thutapea/milotx/0.3mmviaTransmitter/floorplan.png

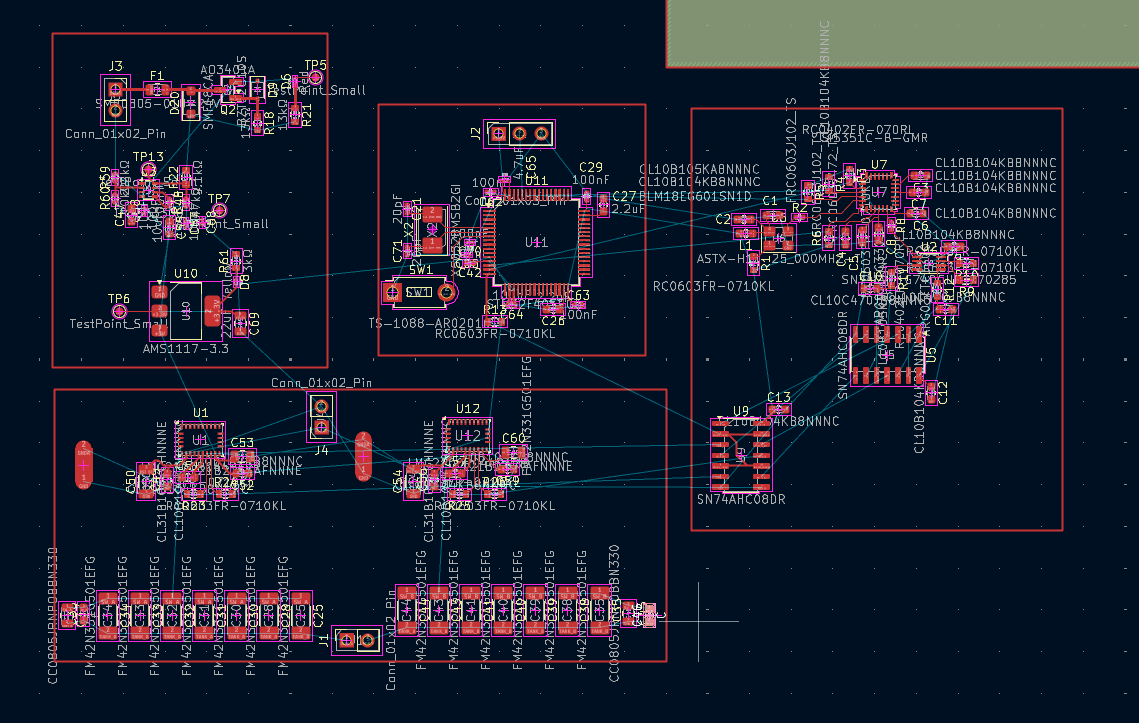
0.3mmviaTransmitter/floorplan.png
