thutapea/milotx/0.3mmviaTransmitter/sim1.png

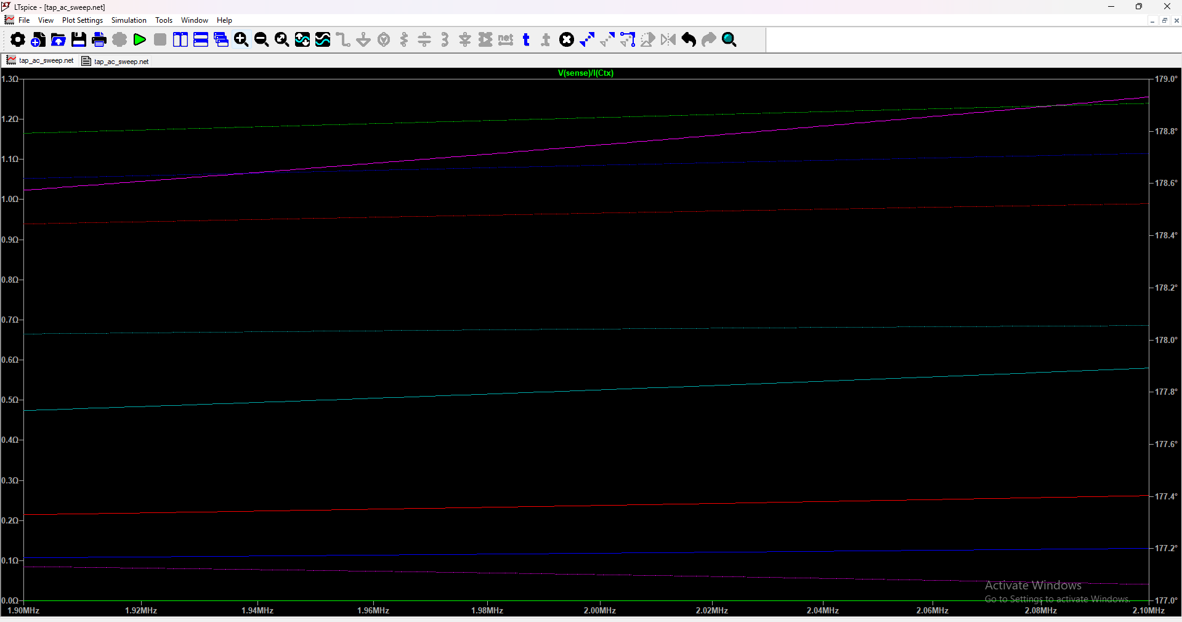
0.3mmviaTransmitter/sim1.png
