thutapea/milotx/0.3mmviaTransmitter/TX/production/bom.csv

Designator | Footprint | Quantity | Value | LCSC Part #
C1, C12, C13, C3, C4, C5, C51, C52, C57, C59, C6, C7, C9 | 0603 | 13 | CL10B104KB8NNNC | C1591
C10, C11 | 0603 | 2 | CL10C470JB8NNNC | C1671
C14, C15 | 0805 | 2 | CL21B105KBFNNNE | C28323
C16 | 1206 | 1 | CL31B475KBHNNNE | C51205
C17 | 0805 | 1 | CL21A226MAQNNNE | C45783
C2, C8 | 0603 | 2 | CL10B105KA8NNNC | C29936
C21, C71 | 0402 | 2 | 20pF | C1554
C25, C28, C30, C31, C32, C33, C34, C35, C38, C39, C40, C41, C43, C44 | 1808 | 14 | FM42N331G501EFG | C22376361
C26, C27 | 0603 | 2 | 2.2uF | C23630
C29, C42, C48, C62, C63, C64 | 0402 | 6 | 100nF | C1525
C37, C45 | 0805 | 2 | CC0805JRNPOBBN330 | C113838
C47, C55 | 0603 | 2 | 10uF | C96446
C49, C56 | 0603 | 2 | CL10B104KC8NNNC | C15725
C50, C54 | 1206 | 2 | CL31B105KCHNNNE | C13832
C53, C60 | 0805 | 2 | CL21B225KAFNNNE | C19110
C58, C68, C70 | 0603 | 3 | 100nF | C14663
C65 | 0603 | 1 | 4.7uF | C19666
C66 | 0603 | 1 | 1uF | C15849
C69 | 0805 | 1 | 22uF | C45783
D20 | D_SOD-123F | 1 | SMF18CA | C19077513
D6 | 0603 | 1 | Red | C2286
D8 | 0603 | 1 | Yellow | C89811
D9 | D_SOD-323 | 1 | BZT52C10S | C19077446
F2 | SMD1812P050TF_30_C492015 | 1 | SMD1812P050TF_30_C492015 | C492015
L1 | 0603 | 1 | BLM18EG601SN1D | C20345
Q2 | SOT-23 | 1 | AO3401A
R1, R10, R13, R23, R24, R25, R26, R6, R9 | 0603 | 9 | RC0603FR-0710KL | C98220
R11, R12 | 0603 | 2 | ARG03FTC3300 | C217969
R18, R21 | 0603 | 2 | 13kΩ | C22797
R2, R8 | 0402 | 2 | RC0402FR-070RL | C106231
R22 | 0603 | 1 | 9.1kΩ | C23260
R3 | 0603 | 1 | FRC0603J472_TS | C2907166
R34 | 0402 | 1 | 47kΩ | C25792
R4, R5 | 0603 | 2 | FRC0603J102_TS | C2907113
R59 | 0402 | 1 | 2.2kΩ | C25879
R60 | 0402 | 1 | 10kΩ | C25744
R61 | 0603 | 1 | 3kΩ | C4211
RF1 | SMA-KWE901 | 1 | SMA-KWE901 | C914553
SW1 | SW_PUSH_1P1T_6x3.5mm_H5.0_APEM_MJTP1250 | 1 | TS-1088-AR02016 | C54141293
U1, U12 | LMG2100R044RARR | 2 | LMG2100R044RARR | C22453052
U10 | SOT-223-3_TabPin2 | 1 | AMS1117-3.3
U11 | LQFP-64_10x10mm_P0.5mm | 1 | STM32F405RGTx | C15742
U13 | SRR1208-120ML | 1 | SRR1208-120ML | C1329356
U2 | VSSOP-8_2.3x2mm_P0.5mm | 1 | SN74LVC1G74DCUR_C70285 | C70285
U3 | SOT-583-8 | 1 | TPS563300
U4, U8 | Molex_Micro-Fit_3.0_43045-0412_2x02_P3.00mm_Vertical | 2 | 430450412 | C277721
U5, U9 | SOIC-14_3.9x8.7mm_P1.27mm | 2 | SN74AHC08DR | C6937
U6 | Crystal_SMD_3225-4Pin_3.2x2.5mm | 1 | ASTX-H11-25_000MHZ-T | C7217716
U7 | SI5351C-B-GMR | 1 | SI5351C-B-GMR | C2649375
X2 | Crystal_SMD_5032-2Pin_5.0x3.2mm | 1 | X50328MSB2GI | C115962
