thutapea/milotx/0.3mmviaTransmitter/TX/TX.kicad_pcb

## KiCad design 0.3mmviaTransmitter/TX/TX.kicad_pcb (2026-10-14)

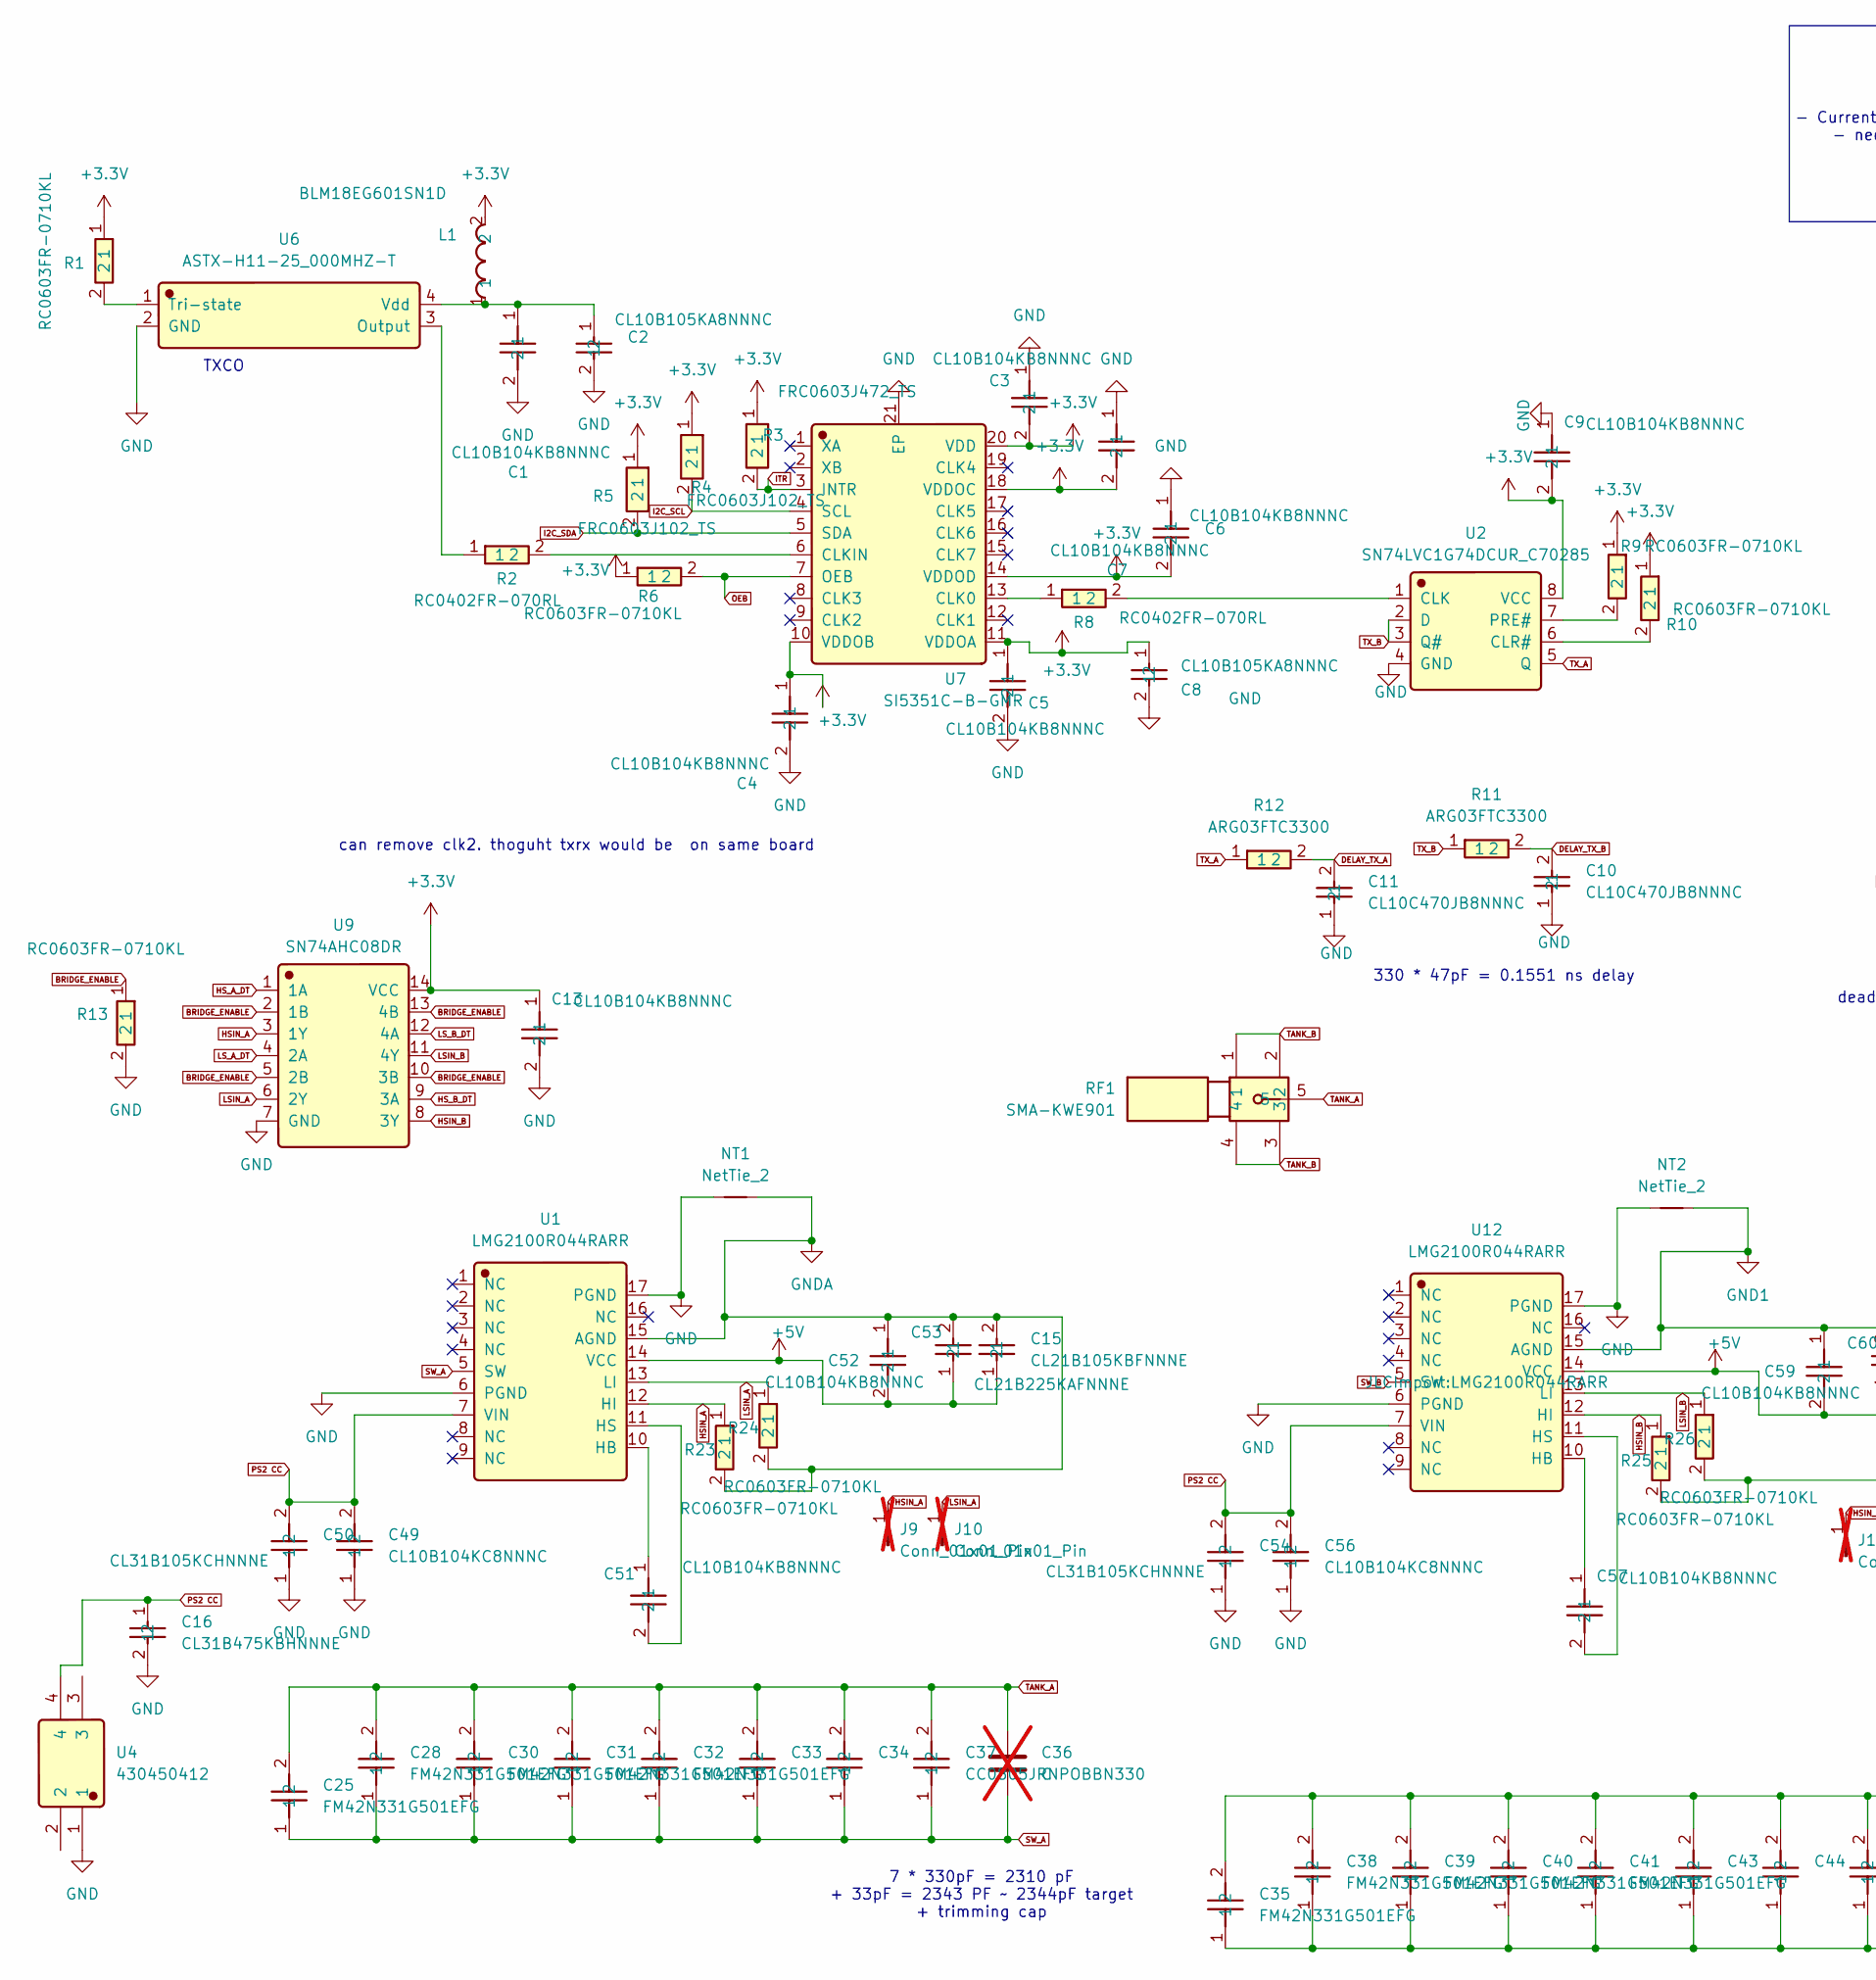
[picture p3: schematic TX.kicad_sch, part in row 1, column 1]

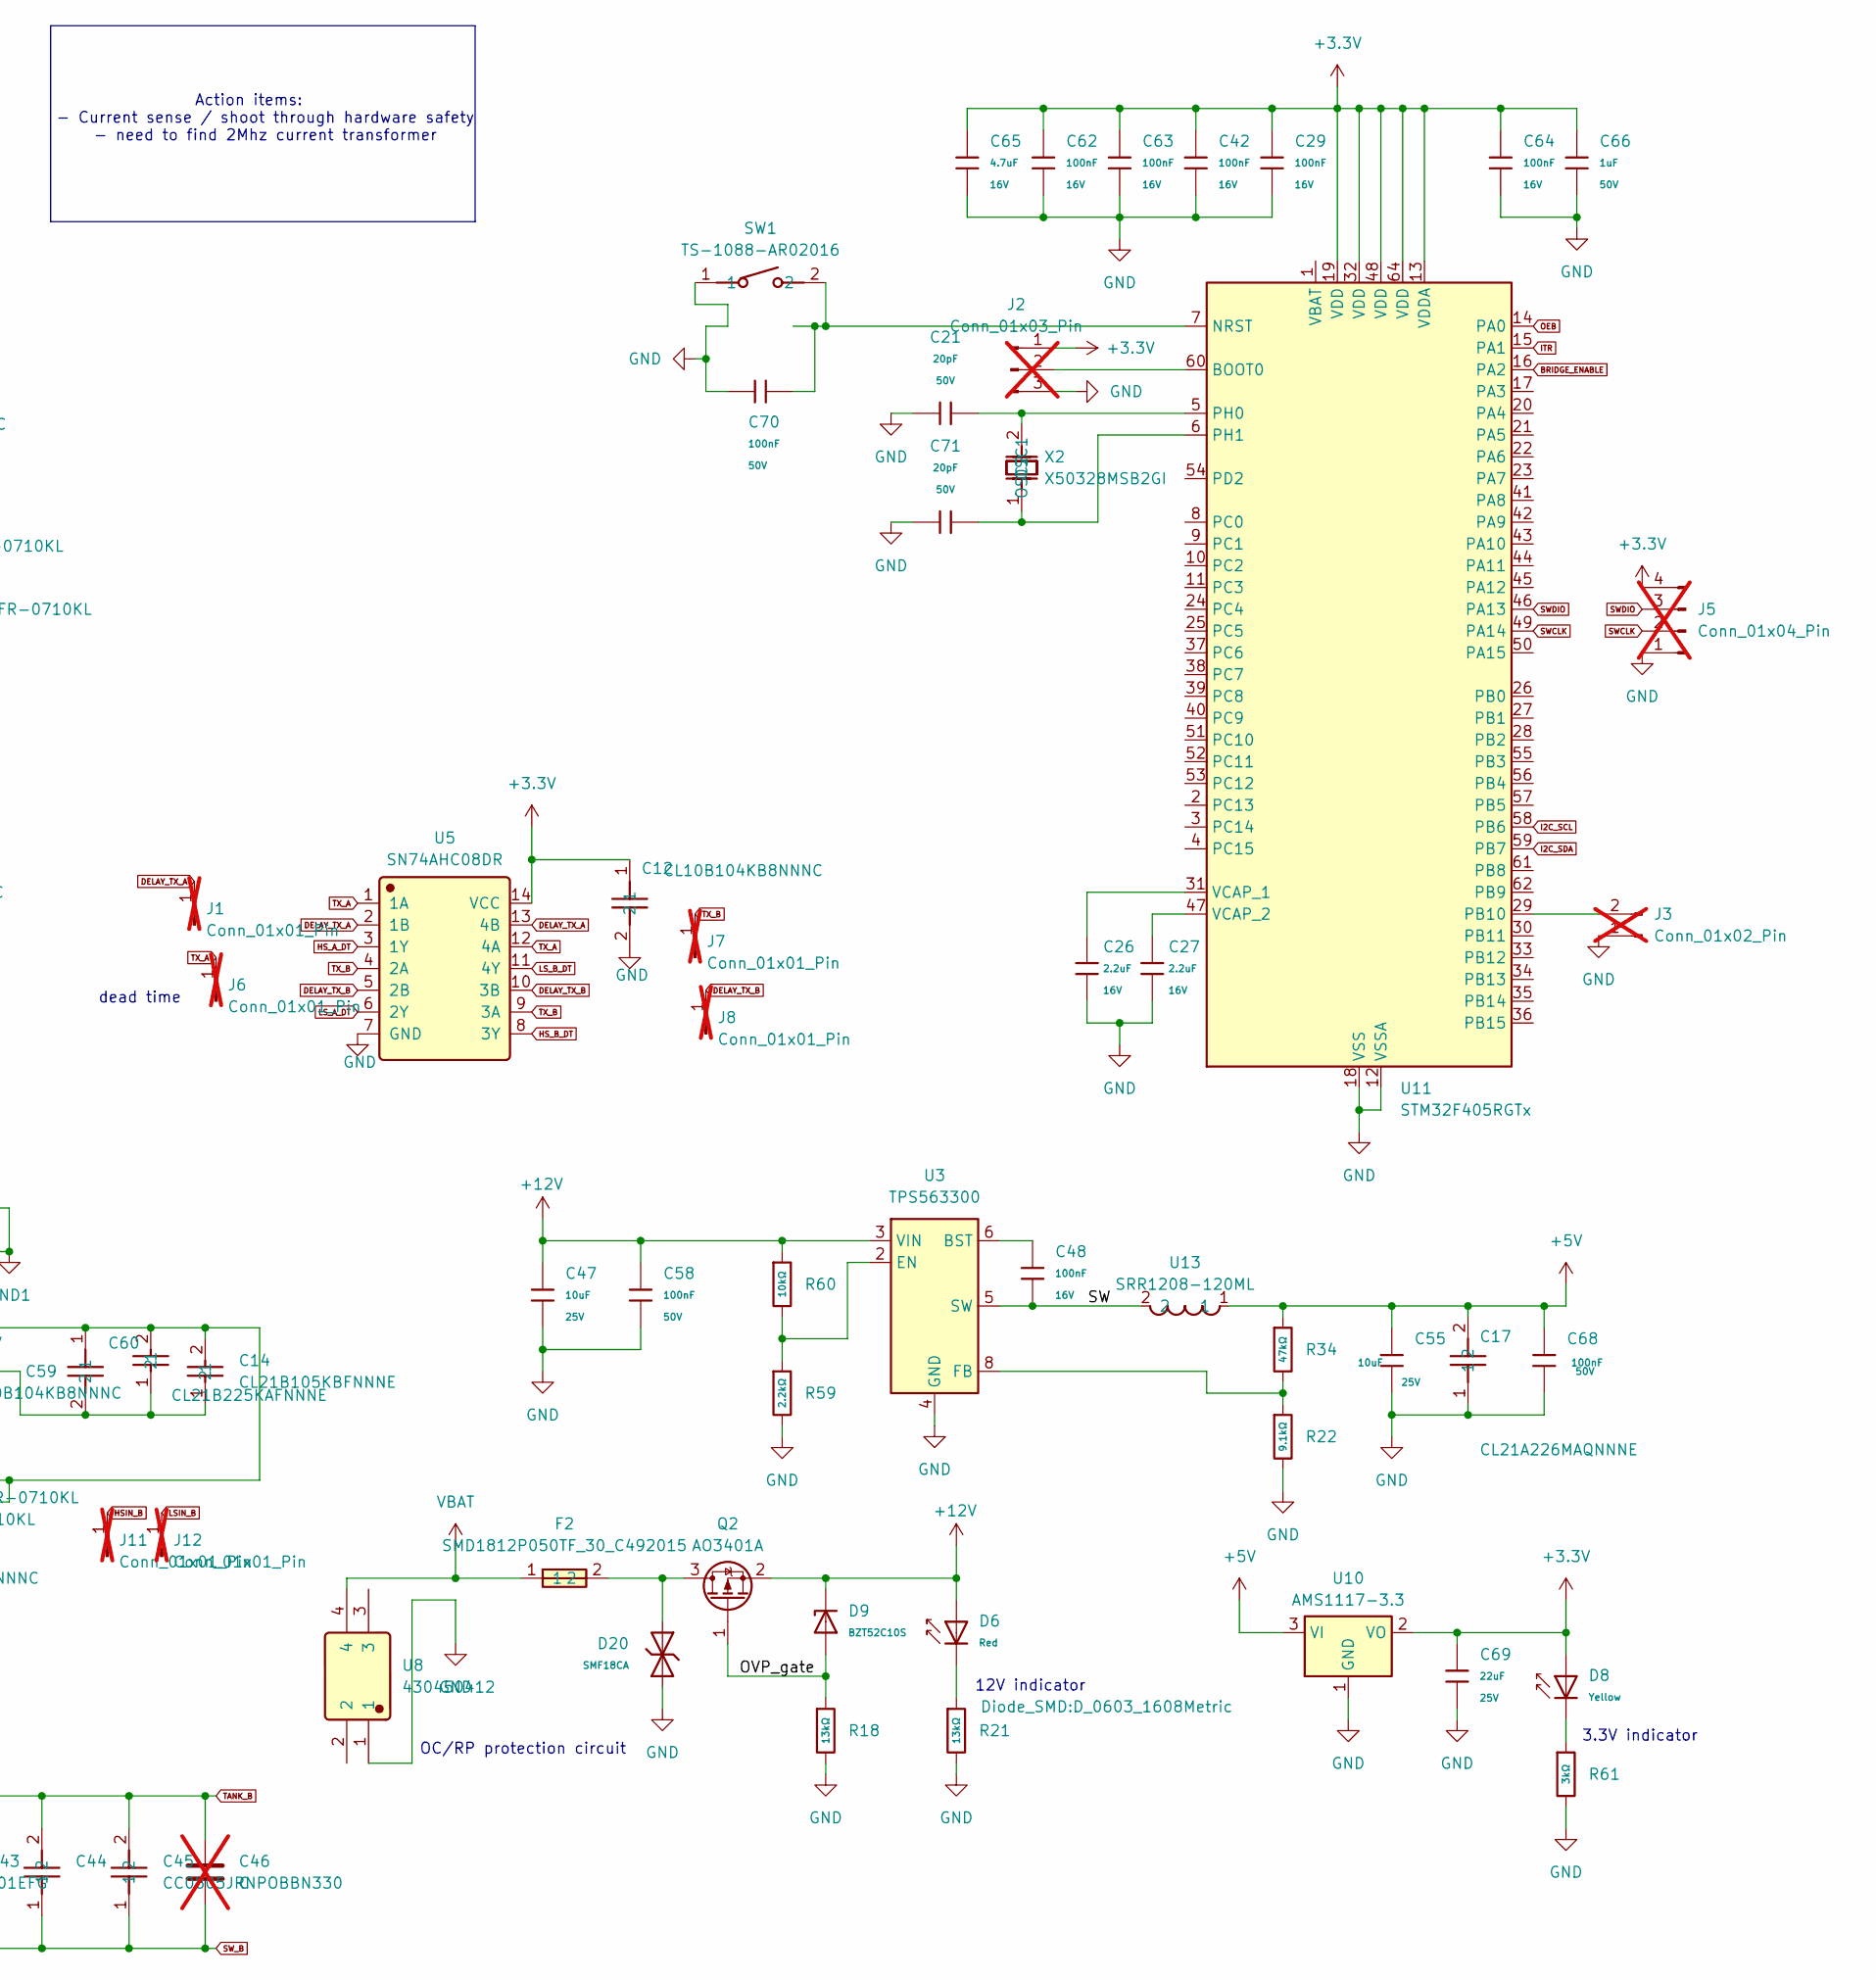
[picture p4: schematic TX.kicad_sch, part in row 1, column 2]

Parts:
C1, C3, C4, C5, C6, C7, C9, C12, C13, C51, C52, C57, C59: CL10B104KB8NNNC; C_0603_1608Metric; Manufacturer Part CL10B104KB8NNNC; LCSC C1591
C2, C8: CL10B105KA8NNNC; C_0603_1608Metric; Manufacturer Part CL10B105KA8NNNC; LCSC C29936
C10, C11: CL10C470JB8NNNC; C_0603_1608Metric; Manufacturer Part CL10C470JB8NNNC; LCSC C1671
C14, C15: CL21B105KBFNNNE; C_0805_2012Metric; Manufacturer Part CL21B105KBFNNNE; LCSC C28323
C16: CL31B475KBHNNNE; C_1206_3216Metric; Manufacturer Part CL31B475KBHNNNE; LCSC C51205
C17: CL21A226MAQNNNE; C_0805_2012Metric; Manufacturer Part CL21A226MAQNNNE; LCSC C45783
C21, C71: 20pF; C_0402_1005Metric; Voltage Rated 50V; Tolerance ±5%; Part 0402CG200J500NT; LCSC C1554
C25, C28, C30, C31, C32, C33, C34, C35, C38, C39, C40, C41, C43, C44: FM42N331G501EFG; C_1808_4520Metric; Manufacturer Part FM42N331G501EFG; LCSC C22376361
C26, C27: 2.2uF; C_0603_1608Metric; Voltage Rated 16V; Tolerance ±10%; Part CL10A225KO8NNNC; LCSC C23630
C29, C42, C48, C62, C63, C64: 100nF; C_0402_1005Metric; Voltage Rated 16V; Tolerance ±10%; Part CL05B104KO5NNNC; LCSC C1525
C36, C46: C; C_0603_1608Metric; not fitted
C37, C45: CC0805JRNPOBBN330; C_0805_2012Metric; Manufacturer Part CC0805JRNPOBBN330; LCSC C113838
C47, C55: 10uF; C_0603_1608Metric; Voltage Rated 25V; Tolerance ±20%; Part CL10A106MA8NRNC; LCSC C96446
C49, C56: CL10B104KC8NNNC; C_0603_1608Metric; Manufacturer Part CL10B104KC8NNNC; LCSC C15725
C50, C54: CL31B105KCHNNNE; C_1206_3216Metric; Manufacturer Part CL31B105KCHNNNE; LCSC C13832
C53, C60: CL21B225KAFNNNE; C_0805_2012Metric; Manufacturer Part CL21B225KAFNNNE; LCSC C19110
C58, C68, C70: 100nF; C_0603_1608Metric; Voltage Rated 50V; Tolerance ±10%; Part CC0603KRX7R9BB104; LCSC C14663
C65: 4.7uF; C_0603_1608Metric; Voltage Rated 16V; Tolerance ±10%; Part CL10A475KO8NNNC; LCSC C19666
C66: 1uF; C_0603_1608Metric; Voltage Rated 50V; Tolerance ±10%; Part CL10A105KB8NNNC; LCSC C15849
C69: 22uF; C_0805_2012Metric; Voltage Rated 25V; Tolerance ±20%; Part CL21A226MAQNNNE; LCSC C45783
D6: Red; D_0603_1608Metric; Part KT-0603R; LCSC C2286
D8: Yellow; D_0603_1608Metric; Forward Voltage (VF) 1.6V~2.6V; Part NCD0603Y2; LCSC C89811
D9: BZT52C10S; D_SOD-323; Part BZT52C10S; LCSC C19077446
D20: SMF18CA; D_SOD-123F; Breakdown Voltage 20V; Part SMF18CA; LCSC C19077513
F2: SMD1812P050TF_30_C492015; Manufacturer Part SMD1812P050TF/30; LCSC C492015
J1, J6, J7, J8, J9, J10, J11, J12: Conn_01x01_Pin; PinHeader_1x01_P2.54mm_Vertical; not fitted
J2: Conn_01x03_Pin; PinSocket_1x03_P2.54mm_Vertical; not fitted
J3: Conn_01x02_Pin; PinHeader_1x02_P2.54mm_Vertical; not fitted
J5: Conn_01x04_Pin; PinHeader_1x04_P2.54mm_Vertical; not fitted
L1: BLM18EG601SN1D; L_0603_1608Metric; Manufacturer Part BLM18EG601SN1D; LCSC C20345
NT1, NT2: NetTie_2; NetTie-2_SMD_Pad2.0mm
Q2: AO3401A; SOT-23
R1, R6, R9, R10, R13, R23, R24, R25, R26: RC0603FR-0710KL; R_0603_1608Metric; Manufacturer Part RC0603FR-0710KL; LCSC C98220
R2, R8: RC0402FR-070RL; R_0402_1005Metric; Manufacturer Part RC0402FR-070RL; LCSC C106231
R3: FRC0603J472_TS; R_0603_1608Metric; Manufacturer Part FRC0603J472 TS; LCSC C2907166
R4, R5: FRC0603J102_TS; R_0603_1608Metric; Manufacturer Part FRC0603J102 TS; LCSC C2907113
R11, R12: ARG03FTC3300; R_0603_1608Metric; Manufacturer Part ARG03FTC3300; LCSC C217969
R18, R21: 13kΩ; R_0603_1608Metric; Overload Voltage (Max) 75V; Tolerance ±1%; Part 0603WAF1302T5E; LCSC C22797
R22: 9.1kΩ; R_0603_1608Metric; Overload Voltage (Max) 75V; Tolerance ±1%; Part 0603WAF9101T5E; LCSC C23260
R34: 47kΩ; R_0402_1005Metric; Overload Voltage (Max) 50V; Tolerance ±1%; Part 0402WGF4702TCE; LCSC C25792
R59: 2.2kΩ; R_0402_1005Metric; Overload Voltage (Max) 50V; Tolerance ±1%; Part 0402WGF2201TCE; LCSC C25879
R60: 10kΩ; R_0402_1005Metric; Overload Voltage (Max) 50V; Tolerance ±1%; Part 0402WGF1002TCE; LCSC C25744
R61: 3kΩ; R_0603_1608Metric; Overload Voltage (Max) 75V; Tolerance ±1%; Part 0603WAF3001T5E; LCSC C4211
RF1: SMA-KWE901; Manufacturer Part SMA-KWE901; LCSC C914553
SW1: TS-1088-AR02016; SW_PUSH_1P1T_6x3.5mm_H5.0_APEM_MJTP1250; Manufacturer Part TS-1088-AR02016; LCSC C54141293
U1, U12: LMG2100R044RARR; Manufacturer Part LMG2100R044RARR; LCSC C22453052
U2: SN74LVC1G74DCUR_C70285; VSSOP-8_2.3x2mm_P0.5mm; Manufacturer Part SN74LVC1G74DCUR; LCSC C70285
U3: TPS563300; SOT-583-8
U4, U8: 430450412; Molex_Micro-Fit_3.0_43045-0412_2x02_P3.00mm_Vertical; Manufacturer Part 430450412; LCSC C277721
U5, U9: SN74AHC08DR; SOIC-14_3.9x8.7mm_P1.27mm; Manufacturer Part SN74AHC08DR; LCSC C6937
U6: ASTX-H11-25_000MHZ-T; Crystal_SMD_3225-4Pin_3.2x2.5mm; Manufacturer Part ASTX-H11-25.000MHZ-T; LCSC C7217716
U7: SI5351C-B-GMR; Manufacturer Part SI5351C-B-GMR; LCSC C2649375
U10: AMS1117-3.3; SOT-223-3_TabPin2
U11: STM32F405RGTx; LQFP-64_10x10mm_P0.5mm; LCSC C15742
U13: SRR1208-120ML; Manufacturer Part SRR1208-120ML; LCSC C1329356
X2: X50328MSB2GI; Crystal_SMD_5032-2Pin_5.0x3.2mm; Manufacturer Part X50328MSB2GI; LCSC C115962

Connections:
+3.3V: C3.2, C4.1, C5.1, C6.2, C7.2, C8.1, C9.2, C12.1, C13.1, C29.1, C42.1, C62.1, C63.1, C64.1, C65.1, C66.1, C69.1, D8.2, J2.1, J5.4, L1.2, R1.1, R3.1, R4.1, R5.1, R6.1, R9.1, R10.1, U2.8 (VCC), U5.14 (VCC), U7.10 (VDDOB), U7.11 (VDDOA), U7.14 (VDDOD), U7.18 (VDDOC), U7.20 (VDD), U9.14 (VCC), U10.2 (VO), U11.13 (VDDA), U11.19 (VDD), U11.32 (VDD), U11.48 (VDD), U11.64 (VDD); also elsewhere on the board
+5V: C14.1, C15.1, C17.2, C52.2, C53.1, C55.1, C59.2, C60.1, C68.1, R34.1, U1.14 (VCC), U10.3 (VI), U12.14 (VCC), U13.1
+12V: C47.1, C58.1, D6.2, D9.1, Q2.2 (S), R60.1, U3.3 (VIN); also elsewhere on the board
/OVP_gate: D9.2, Q2.1 (G), R18.1
/SW: C48.2, U3.5 (SW), U13.2
BRIDGE_ENABLE: R13.1, U9.2 (1B), U9.5 (2B), U9.10 (3B), U9.13 (4B), U11.16 (PA2)
DELAY_TX_A: C11.2, J1.1 (Pin_1_1), R12.2, U5.2 (1B), U5.13 (4B)
DELAY_TX_B: C10.2, J8.1 (Pin_1_1), R11.2, U5.5 (2B), U5.10 (3B)
GND: C1.2, C2.2, C3.1, C4.2, C5.2, C6.1, C7.1, C8.2, C9.1, C10.1, C11.1, C12.2, C13.2, C16.2, C17.1, C21.1, C26.2, C27.2, C29.2, C42.2, C47.2, C49.1, C50.1, C54.1, C55.2, C56.1, C58.2, C62.2, C63.2, C64.2, C65.2, C66.2, C68.2, C69.2, C70.2, C71.1, D20.1, J2.3, J3.1, J5.1, NT1.1, NT2.1, R13.2, R18.2, R21.2, R22.2, R59.2, R61.2, SW1.1, U1.6 (PGND), U1.17 (PGND), U2.4 (GND), U3.4 (GND), U4.1, U5.7 (GND), U6.2 (GND), U7.21 (EP), U8.1, U9.7 (GND), U10.1 (GND), U11.12 (VSSA), U11.18 (VSS), U11.63 (VSS), U12.6 (PGND), U12.17 (PGND)
GND1: C14.2, C59.1, C60.2, NT2.2, R25.2, R26.2, U12.15 (AGND)
GNDA: C15.2, C52.1, C53.2, NT1.2, R23.2, R24.2, U1.15 (AGND)
HSIN_A: J9.1 (Pin_1_1), R23.1, U1.12 (HI), U9.3 (1Y)
HSIN_B: J11.1 (Pin_1_1), R25.1, U9.8 (3Y), U12.12 (HI)
HS_A_DT: U5.3 (1Y), U9.1 (1A)
HS_B_DT: U5.8 (3Y), U9.9 (3A)
I2C_SCL: R4.2, U7.4 (SCL), U11.58 (PB6)
I2C_SDA: R5.2, U7.5 (SDA), U11.59 (PB7)
ITR: R3.2, U7.3 (INTR), U11.15 (PA1)
LSIN_A: J10.1 (Pin_1_1), R24.1, U1.13 (LI), U9.6 (2Y)
LSIN_B: J12.1 (Pin_1_1), R26.1, U9.11 (4Y), U12.13 (LI)
LS_A_DT: U5.6 (2Y), U9.4 (2A)
LS_B_DT: U5.11 (4Y), U9.12 (4A)
unnamed: D6.1, R21.1
unnamed: D8.1, R61.1
unnamed: J2.2, U11.60 (BOOT0)
unnamed: J3.2, U11.29 (PB10)
unnamed: D20.2, F2.2, Q2.3 (D)
unnamed: C51.1, U1.10 (HB)
unnamed: C51.2, U1.11 (HS)
unnamed: R8.2, U2.1 (CLK)
unnamed: R9.2, U2.6 (CLR#)
unnamed: R10.2, U2.7 (PRE#)
unnamed: C48.1, U3.6 (BST)
unnamed: R59.1, R60.2, U3.2 (EN)
unnamed 34: R22.1, R34.2, U3.8 (FB); also elsewhere on the board
unnamed: R2.1, U6.3 (Output)
unnamed: R1.2, U6.1 (Tri-state)
unnamed: C1.1, C2.1, L1.1, U6.4 (Vdd)
unnamed: R8.1, U7.13 (CLK0)
unnamed: R2.2, U7.6 (CLKIN)
unnamed: C70.1, SW1.2, U11.7 (NRST)
unnamed: C21.2, U11.5 (PH0), X2.2 (OSC2)
unnamed: C71.2, U11.6 (PH1), X2.1 (OSC1)
unnamed: C26.1, U11.31 (VCAP_1)
unnamed: C27.1, U11.47 (VCAP_2)
unnamed: C57.1, U12.10 (HB)
unnamed: C57.2, U12.11 (HS)
OEB: R6.2, U7.7 (OEB), U11.14 (PA0)
PS2 CC: C16.1, C49.2, C50.2, C54.2, C56.2, U1.7 (VIN), U4.4, U12.7 (VIN)
SWCLK: J5.2, U11.49 (PA14)
SWDIO: J5.3, U11.46 (PA13)
SW_A: C25.1, C28.1, C30.1, C31.1, C32.1, C33.1, C34.1, C36.2, C37.1, U1.5 (SW)
SW_B: C35.1, C38.1, C39.1, C40.1, C41.1, C43.1, C44.1, C45.1, C46.2, U12.5 (SW)
TANK_A: C25.2, C28.2, C30.2, C31.2, C32.2, C33.2, C34.2, C36.1, C37.2, RF1.5
TANK_B: C35.2, C38.2, C39.2, C40.2, C41.2, C43.2, C44.2, C45.2, C46.1, RF1.1, RF1.2, RF1.3, RF1.4
TX_A: J6.1 (Pin_1_1), R12.1, U2.5 (Q), U5.1 (1A), U5.12 (4A)
TX_B: J7.1 (Pin_1_1), R11.1, U2.2 (D), U2.3 (Q#), U5.4 (2A), U5.9 (3A)
VBAT: F2.1, U8.4

Notes on the sheet:
TXCO
Action items: - Current sense / shoot through hardware safety - need to find 2Mhz current transformer
7 * 330pF = 2310 pF + 33pF = 2343 PF ~ 2344pF target + trimming cap
330 * 47pF = 0.1551 ns delay
12V indicator
OC/RP protection circuit
dead time
can remove clk2. thoguht txrx would be on same board
3.3V indicator

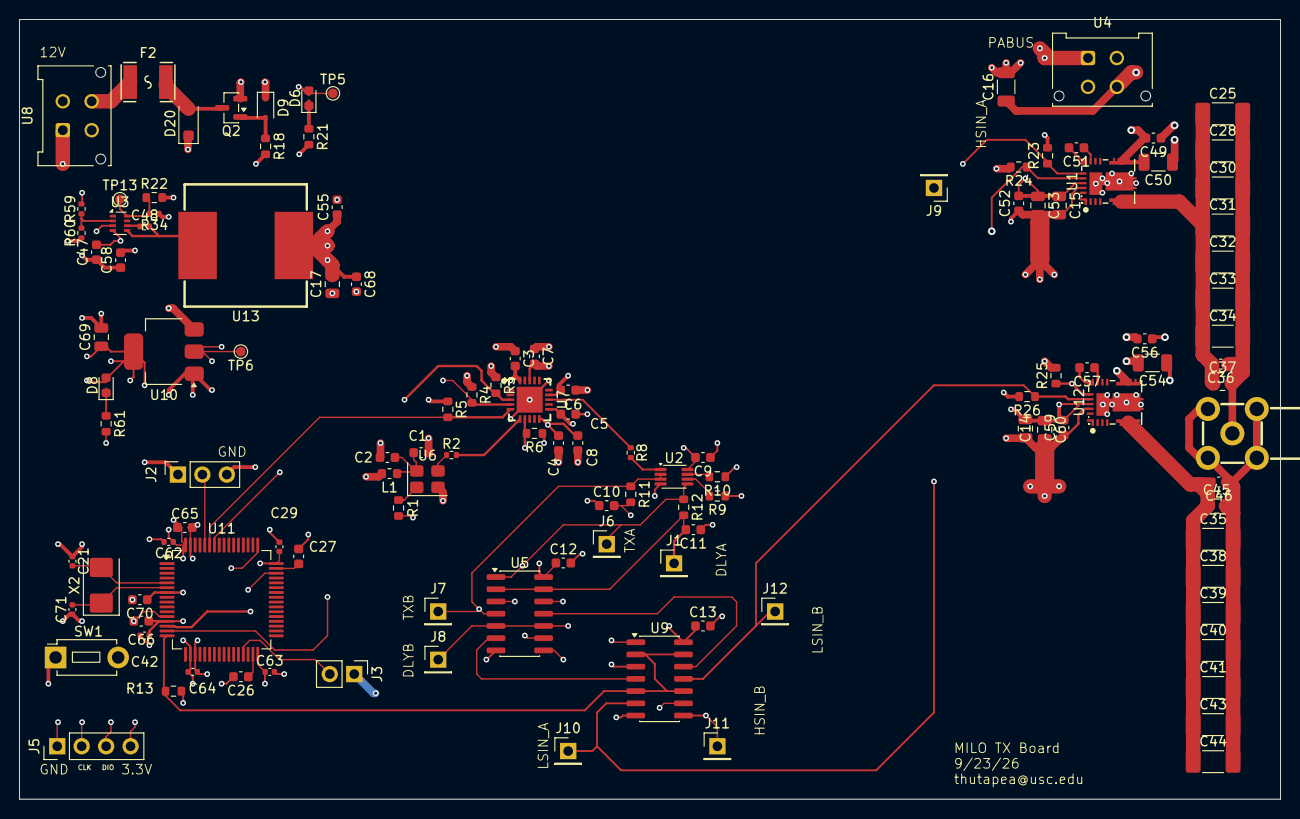
[picture p5: board TX.kicad_pcb from above]

Board: 6 copper layers, 131.0 x 81.0 mm, 125 parts (0 on the bottom side), 58 nets.

Other parts of the board:
TP5, TP6, TP13: TestPoint_Small; TestPoint_Pad_D1.0mm

Their connections:
+3.3V: TP6.1 (1_1); also elsewhere on the board
+12V: TP5.1 (1_1); also elsewhere on the board
unnamed 34: TP13.1 (1_1); also elsewhere on the board
