thutapea/milotx/Core/Src/main.c

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
/* Includes ------------------------------------------------------------------*/
#include "main.h"
#include "i2c.h"
#include "usart.h"
#include "gpio.h"

/* USER CODE BEGIN Includes */
#include "si5351.h"
#include <stdio.h>
#include <string.h>

/* USER CODE END Includes */


void SystemClock_Config(void);
/* USER CODE BEGIN PFP */
static void uart_print(const char *msg);

/* USER CODE END PFP */

/* USER CODE BEGIN 0 */
static void uart_print(const char *msg)
{
  HAL_UART_Transmit(&huart3, (const uint8_t *)msg, (uint16_t)strlen(msg), 100U);
}

/* USER CODE END 0 */

/**
  * @brief  The application entry point.
  * @retval int
  */
int main(void)
{

  /* MCU Configuration--------------------------------------------------------*/

  /* Reset of all peripherals, Initializes the Flash interface and the Systick. */
  HAL_Init();

  /* Configure the system clock */
  SystemClock_Config();

  /* Initialize all configured peripherals */
  MX_GPIO_Init();
  MX_I2C1_Init();
  MX_USART3_UART_Init();
  /* USER CODE BEGIN 2 */
  /* USART3 is single-wire half-duplex: put the line in transmit direction. */
  HAL_HalfDuplex_EnableTransmitter(&huart3);
  uart_print("\r\nmilotx: configuring Si5351 CLK0 = 4 MHz over I2C1\r\n");

  const char *si5351_err = NULL;
  if (si5351_init(&hi2c1) != HAL_OK)
  {
    si5351_err = "no response from Si5351 at 0x60 (check power, SDA/SCL, pull-ups)";
  }
  else if (si5351_set_freq(SI5351_CLK0, SI5351_PLLA, 4000000UL, SI5351_DRIVE_8MA) != HAL_OK)
  {
    si5351_err = "PLLA did not lock (check 25 MHz TCXO on CLKIN)";
  }
  else if (si5351_output_enable(SI5351_CLK0, true) != HAL_OK)
  {
    si5351_err = "I2C write to output enable register failed";
  }

  if (si5351_err == NULL)
  {
    si5351_oeb(true);  /* PA0 low -> outputs on */
    uart_print("Si5351 configuration success: CLK0 = 4 MHz\r\n");
  }
  else
  {
    char line[160];
    uint8_t status = 0xFFU;
    (void)si5351_read_status(&status);
    snprintf(line, sizeof(line), "Si5351 configuration FAILED: %s (status reg 0 = 0x%02X)\r\n",
             si5351_err, status);
    uart_print(line);
  }

  /* USER CODE END 2 */

  /* Infinite loop */
  /* USER CODE BEGIN WHILE */
  while (1)
  {
    /* USER CODE END WHILE */

    /* USER CODE BEGIN 3 */
  }
  /* USER CODE END 3 */
}

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
