thutapea/milotx/milotx.ioc

Mcu.UserName=STM32F405RGTx
PA0-WKUP.Signal=GPIO_Output
PA13.Signal=SYS_JTMS-SWDIO
PA14.Signal=SYS_JTCK-SWCLK
PB10.Signal=USART3_TX
PB6.Signal=I2C1_SCL
PB7.Signal=I2C1_SDA
PH0-OSC_IN.Signal=RCC_OSC_IN
PH1-OSC_OUT.Signal=RCC_OSC_OUT
