thutapea/milotx/(commit log)

2026-10-07 Configure Si5351 CLK0 to 4 MHz over I2C and report over UART
    STM32F405 CubeMX project (I2C1 on PB6/PB7, OEB on PA0, USART3 TX on PB10).
    - Add si5351 driver: datasheet Figure 10 init sequence, integer-mode
    frequency planning, AN619 P1/P2/P3 encoding, PLL lock check.
    - Use the 25 MHz TCXO on CLKIN as the PLL reference (XA/XB unconnected).
    - main.c: program CLK0 = 4 MHz (PLLA 800 MHz / 200), enable the output,
    drive OEB low, print success or the failing step on USART3.
    - usart.c: enable the PB10 pull-up for the open-drain half-duplex TX.
    [main.c, milotx.ioc, si5351.c]
2026-10-14 added pcb
